umgbhalla/deskhop-type-c/Orignal Files/img/impedance-calculation.png

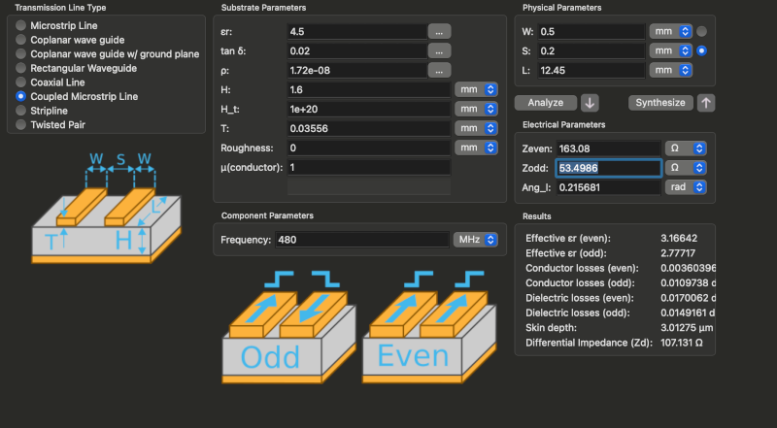
Orignal Files/img/impedance-calculation.png
