umgbhalla/deskhop-type-c/Orignal Files/case/deskhop_case.step

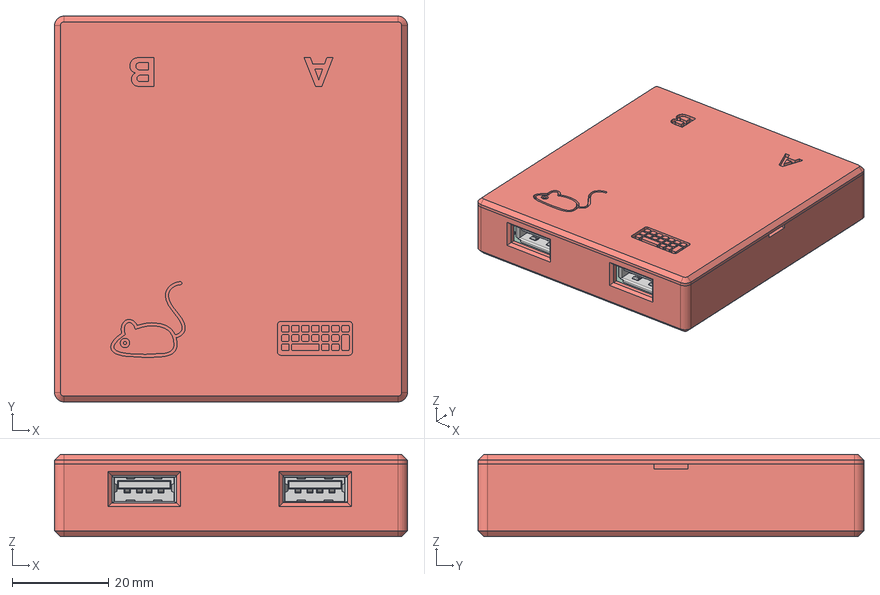
[picture p11: CAD file, 2024-02-20]
Orignal Files/case/deskhop_case.step
73.0 x 79.8 x 17.0 mm
PCB
Box Top
Box Bottom
