umgbhalla/deskhop-type-c/Orignal Files/case/bottom.stl

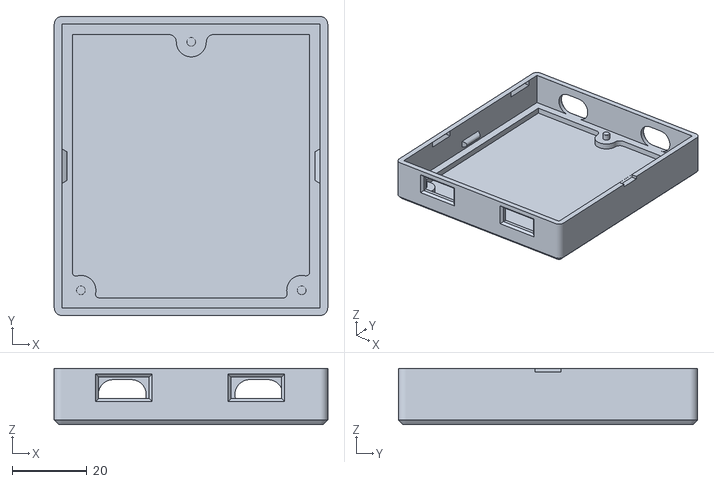
[picture p12: CAD file, 2024-02-20]
Orignal Files/case/bottom.stl
73.0 x 79.8 x 15.0
