umgbhalla/deskhop-type-c/Orignal Files/case/top.stl

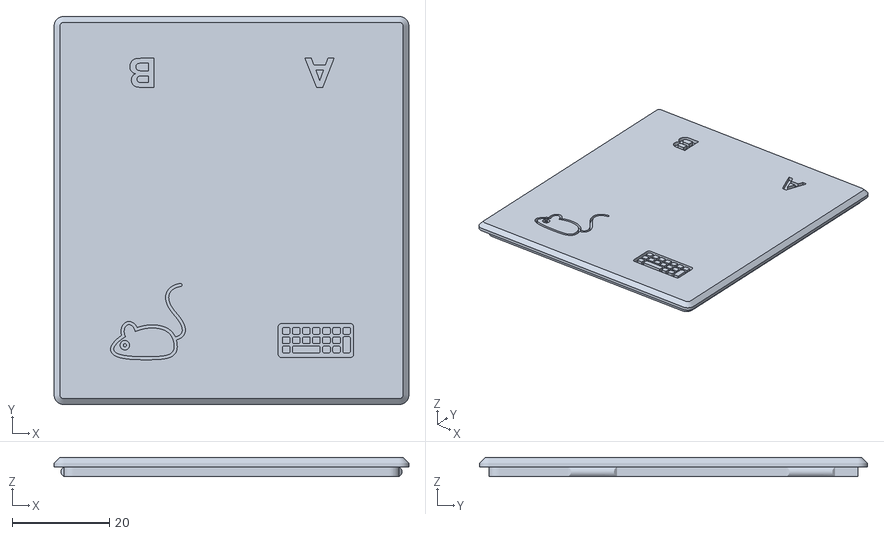
[picture p13: CAD file, 2024-02-20]
Orignal Files/case/top.stl
73.0 x 79.8 x 4.00
