umgbhalla/deskhop-type-c/(list of files, cad)

Other CAD files:
Orignal Files/case/deskhop_case.f3d
