umgbhalla/deskhop-type-c/pcb/DeskHop.kicad_pcb

## KiCad design pcb/DeskHop.kicad_pcb (2024-05-03)

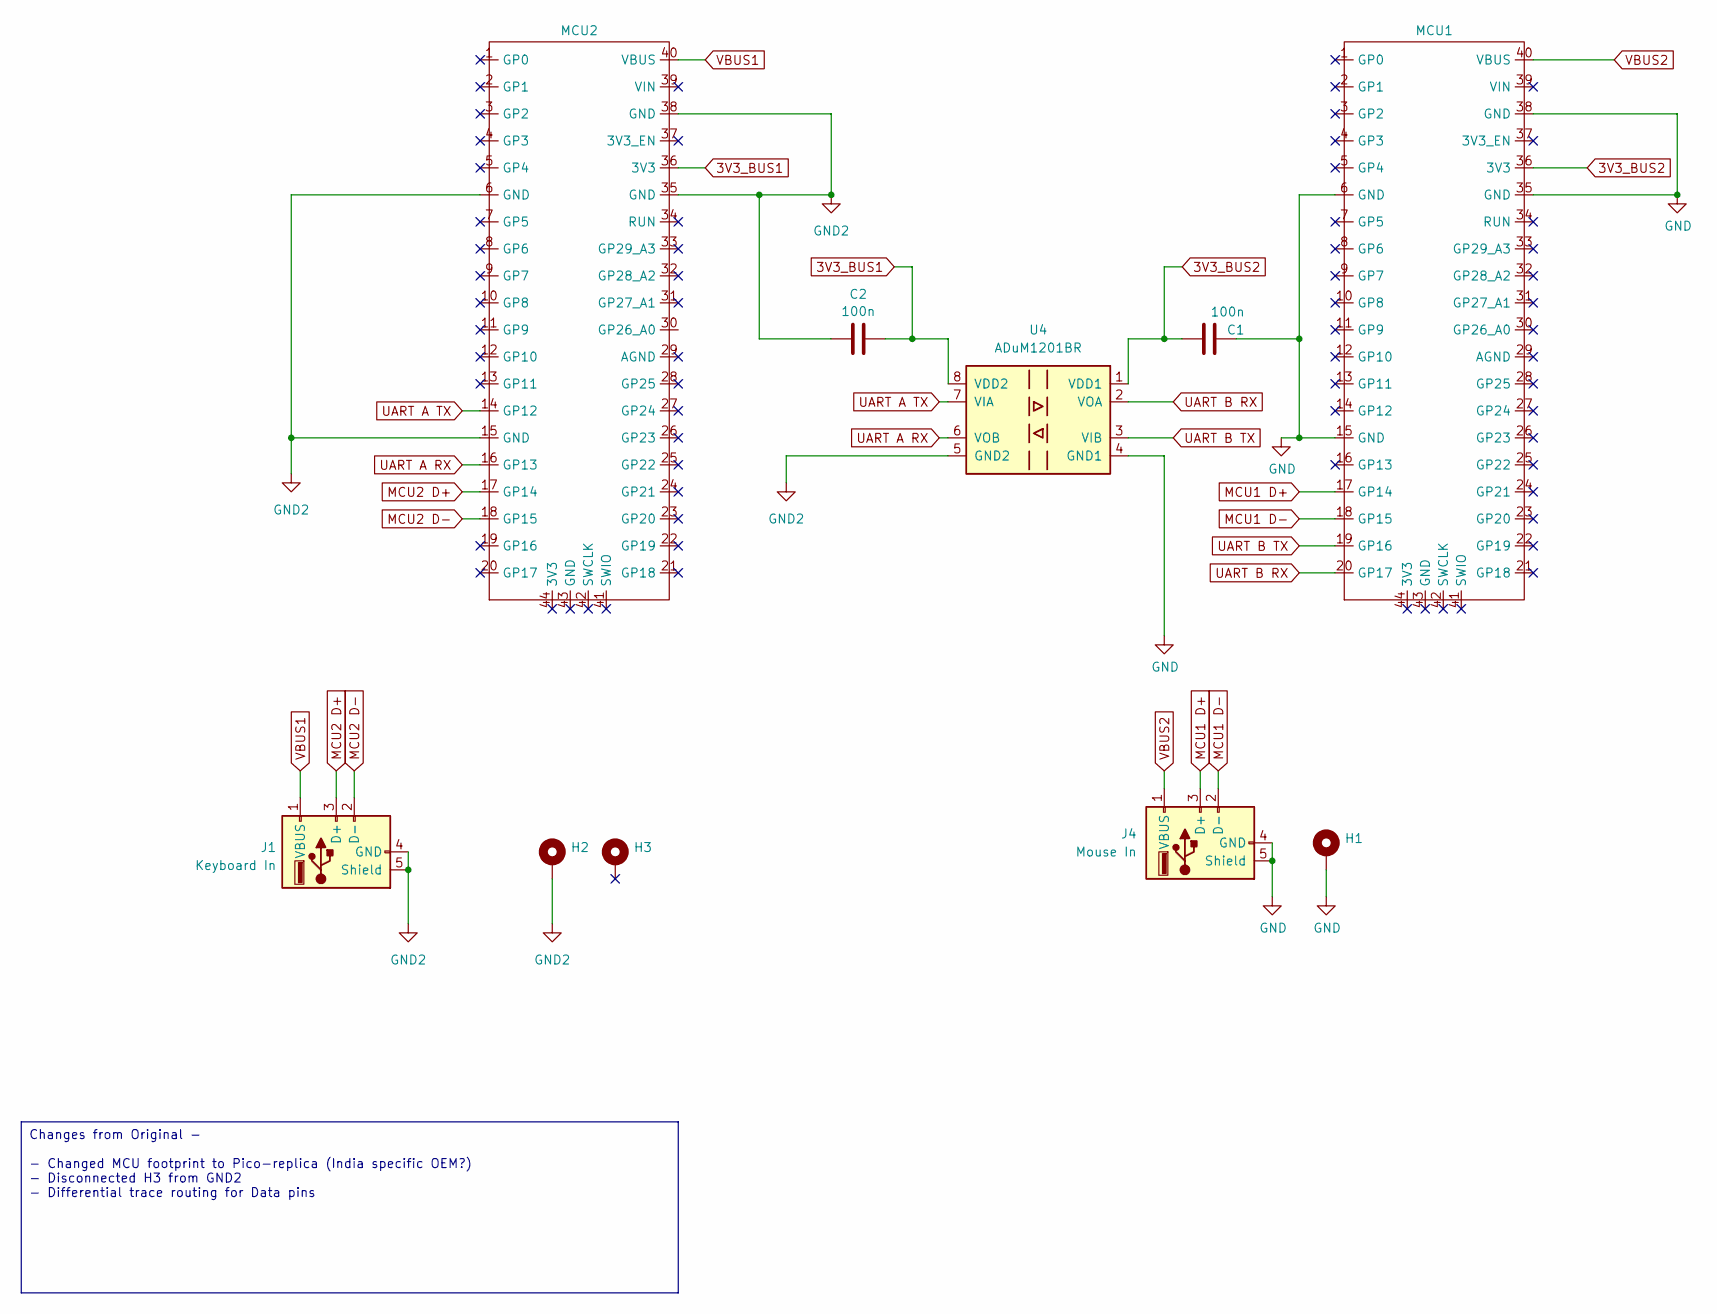
[picture p14: schematic DeskHop.kicad_sch, DeskHop - Fast Keyboard/Mouse Switching Device - Type C]

Parts:
C1, C2: 100n; C_1206_3216Metric_Pad1.33x1.80mm_HandSolder
H1, H2: MountingHole_Pad; MountingHole_2.7mm_M2.5_Pad_TopBottom
H3: MountingHole_Pad; MountingHole_2.7mm_M2.5_Pad_TopOnly
J1: Keyboard In; USB_A_Molex_67643_Horizontal
J4: Mouse In; USB_A_Molex_67643_Horizontal
MCU1, MCU2: Pico_like
U4: ADuM1201BR; SOIC-8_3.9x4.9mm_P1.27mm

Connections:
3V3_BUS1: C2.2, MCU2.36 (3V3), U4.8 (VDD2)
3V3_BUS2: C1.1, MCU1.36 (3V3), U4.1 (VDD1)
GND: C1.2, H1.1, J4.4 (GND), J4.5 (Shield), MCU1.6 (GND), MCU1.15 (GND), MCU1.35 (GND), MCU1.38 (GND), U4.4 (GND1)
GND2: C2.1, H2.1, J1.4 (GND), J1.5 (Shield), MCU2.6 (GND), MCU2.15 (GND), MCU2.35 (GND), MCU2.38 (GND), U4.5 (GND2)
MCU1 D+: J4.3 (D+), MCU1.17 (GP14)
MCU1 D-: J4.2 (D-), MCU1.18 (GP15)
MCU2 D+: J1.3 (D+), MCU2.17 (GP14)
MCU2 D-: J1.2 (D-), MCU2.18 (GP15)
UART A RX: MCU2.16 (GP13), U4.6 (VOB)
UART A TX: MCU2.14 (GP12), U4.7 (VIA)
UART B RX: MCU1.20 (GP17), U4.2 (VOA)
UART B TX: MCU1.19 (GP16), U4.3 (VIB)
VBUS1: J1.1 (VBUS), MCU2.40 (VBUS)
VBUS2: J4.1 (VBUS), MCU1.40 (VBUS)

Notes on the sheet:
Changes from Original - - Changed MCU footprint to Pico-replica (India specific OEM?) - Disconnected H3 from GND2 - Differential trace routing for Data pins

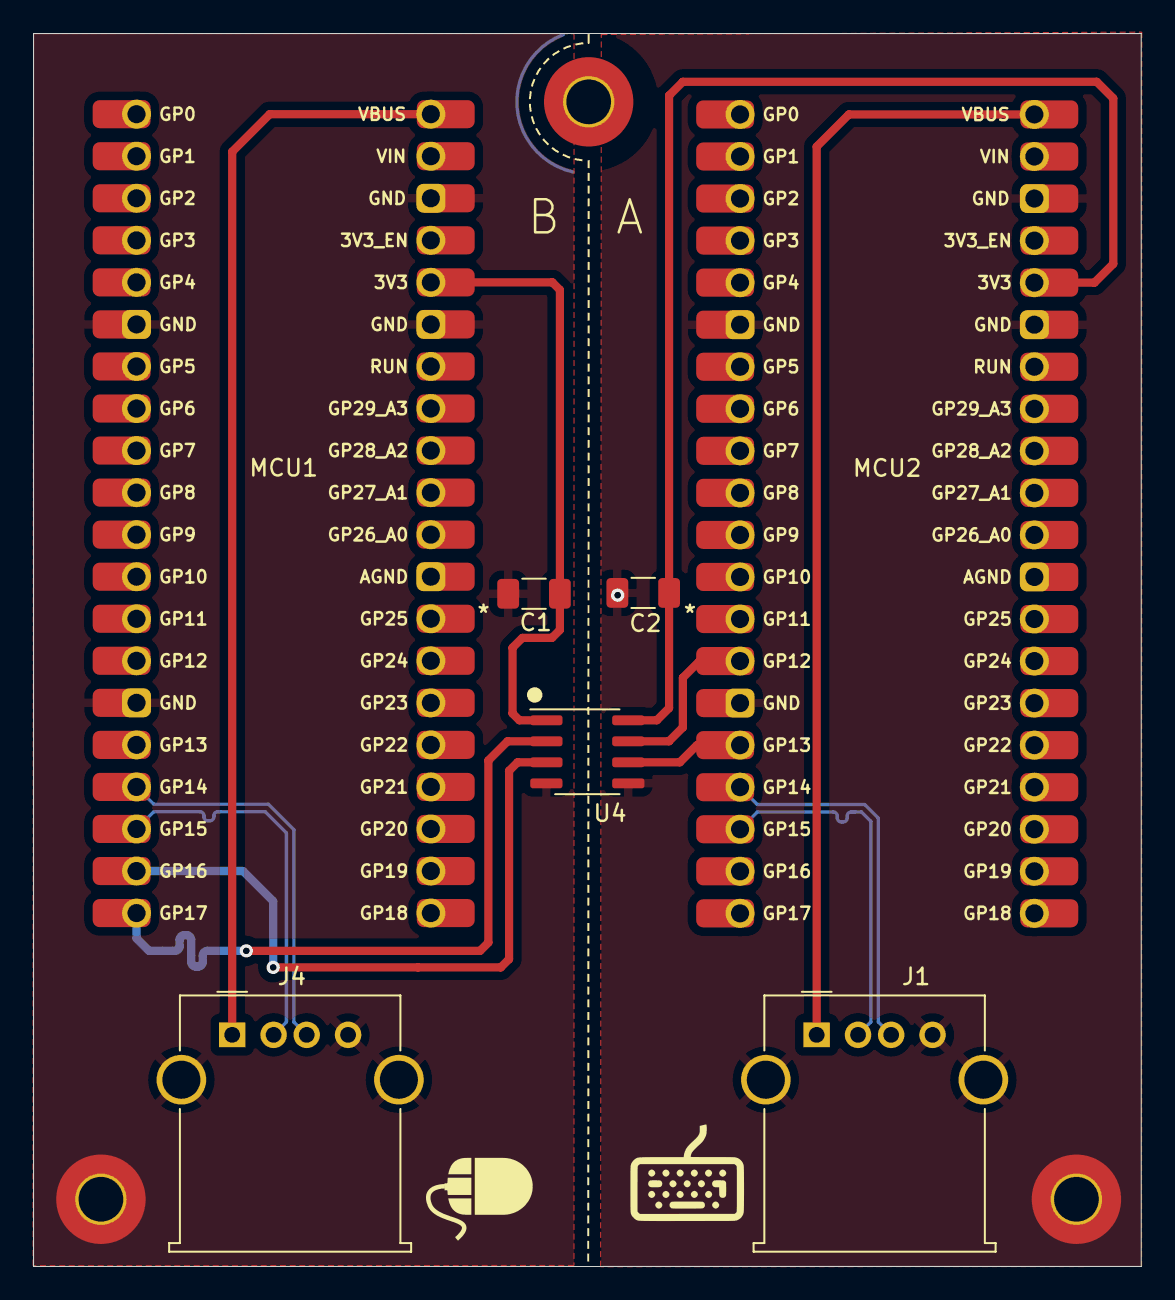
[picture p15: board pcb/DeskHop.kicad_pcb from above]

Board: 2 copper layers, 66.9 x 74.5 mm, 10 parts (0 on the bottom side), 14 nets.
