umgbhalla/deskhop-type-c/Orignal Files/pcb/DeskHop.kicad_pcb

## KiCad design Orignal Files/pcb/DeskHop.kicad_pcb (2024-02-20)

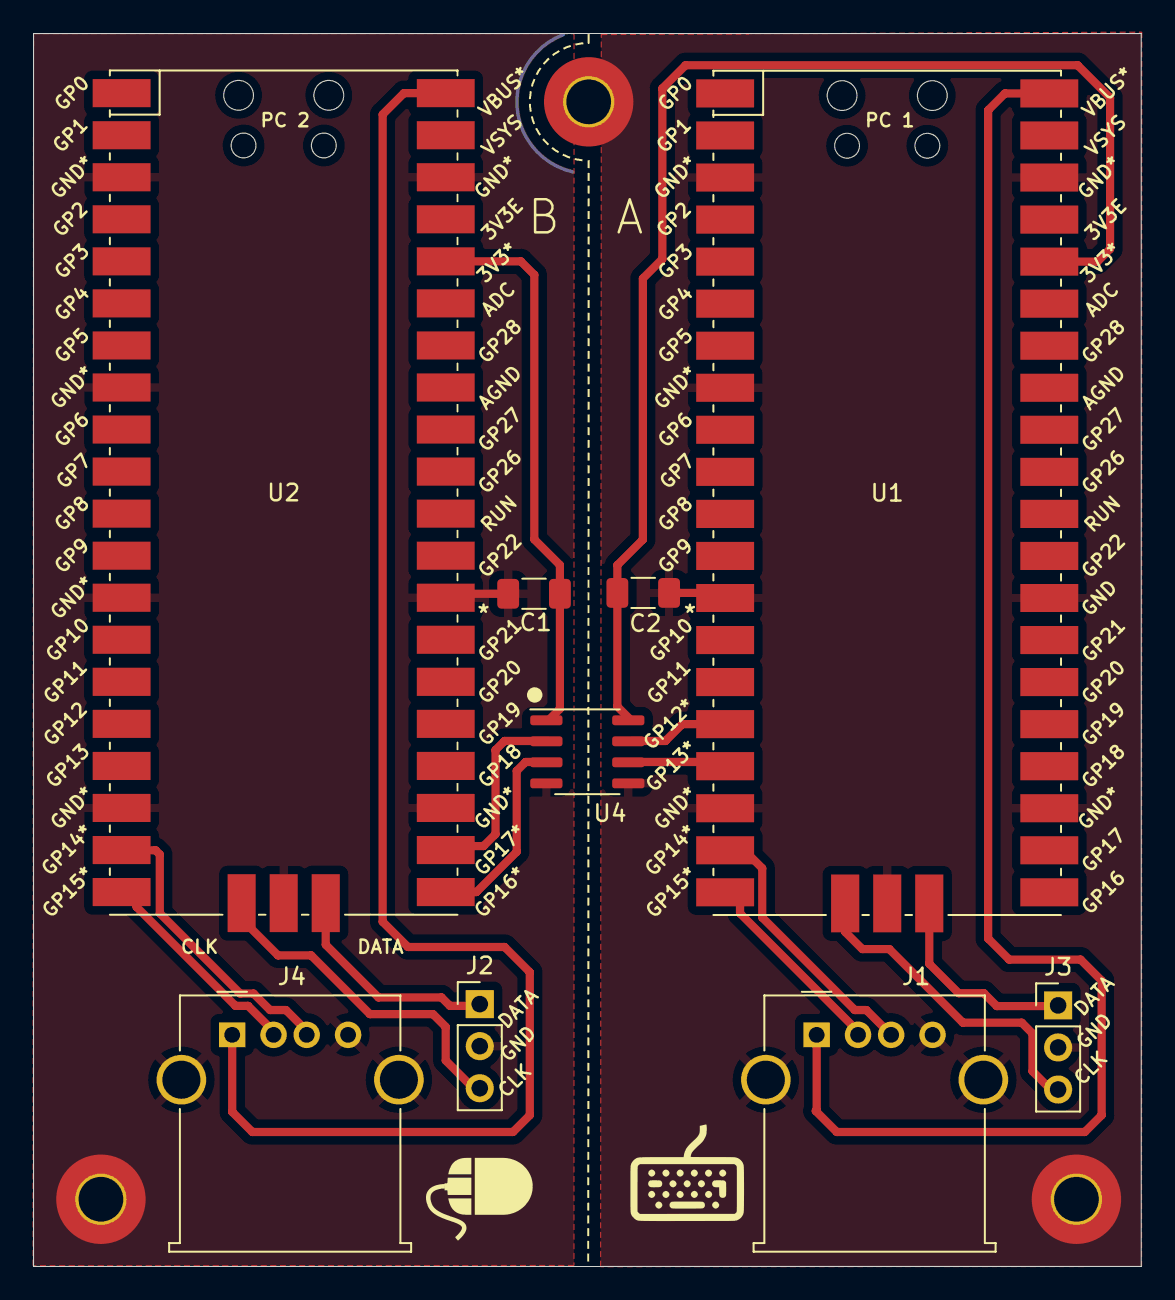
[picture p16: board Orignal Files/pcb/DeskHop.kicad_pcb from above]

Board: 2 copper layers, 66.9 x 74.5 mm, 12 parts (0 on the bottom side), 17 nets.

Parts:
C1, C2: 100n; C_1206_3216Metric_Pad1.33x1.80mm_HandSolder
H1, H2: MountingHole_Pad; MountingHole_2.7mm_M2.5_Pad_TopBottom
H3: MountingHole_Pad; MountingHole_2.7mm_M2.5_Pad_TopOnly
J1: Keyboard In; USB_A_Molex_67643_Horizontal
J2: Debug2; PinHeader_1x03_P2.54mm_Vertical
J3: Debug1; PinHeader_1x03_P2.54mm_Vertical
J4: Mouse In; USB_A_Molex_67643_Horizontal
U1: Pico Primary; RPi_Pico_SMD_Nohole
U2: Pico Secondary; RPi_Pico_SMD_Nohole
U4: ADuM1201BR; SOIC-8_3.9x4.9mm_P1.27mm

Connections:
/UART A TX: U1.16 (GPIO12), U4.7 (VIA)
/UART B RX: U2.22 (GPIO17), U4.2 (VOA)
/UART B TX: U2.21 (GPIO16), U4.3 (VIB)
GND: C1.2, H1.1, J2.2, J4.4 (GND), J4.5 (Shield), U2.3 (GND), U2.8 (GND), U2.13 (GND), U2.18 (GND), U2.23 (GND), U2.28 (GND), U2.38 (GND), U2.42 (GND), U4.4 (GND1)
GND2: C2.2, H2.1, H3.1, J1.4 (GND), J1.5 (Shield), J3.2, U1.3 (GND), U1.8 (GND), U1.13 (GND), U1.18 (GND), U1.23 (GND), U1.28 (GND), U1.38 (GND), U1.42 (GND), U4.5 (GND2)
unnamed: J1.3 (D+), U1.19 (GPIO14)
unnamed: J1.2 (D-), U1.20 (GPIO15)
unnamed: J1.1 (VBUS), U1.40 (VBUS)
unnamed: J2.1, U2.43 (SWDIO)
unnamed: J2.3, U2.41 (SWCLK)
unnamed: J3.1, U1.43 (SWDIO)
unnamed: J3.3, U1.41 (SWCLK)
unnamed: J4.3 (D+), U2.19 (GPIO14)
unnamed: J4.2 (D-), U2.20 (GPIO15)
unnamed: J4.1 (VBUS), U2.40 (VBUS)
unnamed: C2.1, U1.36 (3V3), U4.8 (VDD2)
unnamed: C1.1, U2.36 (3V3), U4.1 (VDD1)
