umgbhalla/deskhop-type-c/Orignal Files/src/handlers.c

/*
 * This file is part of DeskHop (https://github.com/hrvach/deskhop).
 * Copyright (c) 2024 Hrvoje Cavrak
 *
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
 * You should have received a copy of the GNU General Public License
 * along with this program. If not, see <http://www.gnu.org/licenses/>.
 */

#include "main.h"

/**=================================================== *
 * ============  Hotkey Handler Routines  ============ *
 * =================================================== */

/* This is the main hotkey for switching outputs */
void output_toggle_hotkey_handler(device_t *state) {
    /* If switching explicitly disabled, return immediately */
    if (state->switch_lock)
        return;

    state->active_output ^= 1;
    switch_output(state, state->active_output);
};

/* This key combo records switch y top coordinate for different-size monitors  */
void screen_border_hotkey_handler(device_t *state) {
    border_size_t *border = &state->config.output[state->active_output].border;

    /* To avoid having 2 different keys, if we're above half, it's the top coord */
    if (state->mouse_y > (MAX_SCREEN_COORD / 2))
        border->bottom = state->mouse_y;
    else
        border->top = state->mouse_y;

    send_packet((uint8_t *)border, SYNC_BORDERS_MSG, sizeof(border_size_t));
    save_config(state);
};

/* This key combo puts board A in firmware upgrade mode */
void fw_upgrade_hotkey_handler_A(device_t *state) {
    reset_usb_boot(1 << PICO_DEFAULT_LED_PIN, 0);
};

/* This key combo puts board B in firmware upgrade mode */
void fw_upgrade_hotkey_handler_B(device_t *state) {
    send_value(ENABLE, FIRMWARE_UPGRADE_MSG);
};

/* This key combo prevents mouse from switching outputs */
void switchlock_hotkey_handler(device_t *state) {
    state->switch_lock ^= 1;
    send_value(state->switch_lock, SWITCH_LOCK_MSG);
}

/* When pressed, erases stored config in flash and loads defaults on both boards */
void wipe_config_hotkey_handler(device_t *state) {
    wipe_config();
    load_config(state);
    send_value(ENABLE, WIPE_CONFIG_MSG);
}

void screensaver_hotkey_handler(device_t *state) {
    state->config.screensaver_enabled ^= 1;
    send_value(state->config.screensaver_enabled, SCREENSAVER_MSG);
}

/* When pressed, toggles the current mouse zoom mode state */
void mouse_zoom_hotkey_handler(device_t *state) {
    state->mouse_zoom ^= 1;
    send_value(state->mouse_zoom, MOUSE_ZOOM_MSG);
};

/**==================================================== *
 * ==========  UART Message Handling Routines  ======== *
 * ==================================================== */

/* Function handles received keypresses from the other board */
void handle_keyboard_uart_msg(uart_packet_t *packet, device_t *state) {
    queue_kbd_report((hid_keyboard_report_t *)packet->data, state);
    state->last_activity[BOARD_ROLE] = time_us_64();
}

/* Function handles received mouse moves from the other board */
void handle_mouse_abs_uart_msg(uart_packet_t *packet, device_t *state) {
    mouse_abs_report_t *mouse_report = (mouse_abs_report_t *)packet->data;
    queue_mouse_report(mouse_report, state);

    state->mouse_x = mouse_report->x;
    state->mouse_y = mouse_report->y;

    state->last_activity[BOARD_ROLE] = time_us_64();
}

/* Function handles request to switch output  */
void handle_output_select_msg(uart_packet_t *packet, device_t *state) {
    state->active_output = packet->data[0];
    if (state->tud_connected)
        release_all_keys(state);

    restore_leds(state);
}

/* On firmware upgrade message, reboot into the BOOTSEL fw upgrade mode */
void handle_fw_upgrade_msg(uart_packet_t *packet, device_t *state) {
    reset_usb_boot(1 << PICO_DEFAULT_LED_PIN, 0);
}

/* Comply with request to turn mouse zoom mode on/off  */
void handle_mouse_zoom_msg(uart_packet_t *packet, device_t *state) {
    state->mouse_zoom = packet->data[0];
}

/* Process request to update keyboard LEDs */
void handle_set_report_msg(uart_packet_t *packet, device_t *state) {
    state->keyboard_leds[BOARD_ROLE] = packet->data[0];
    restore_leds(state);
}

/* Process request to block mouse from switching, update internal state */
void handle_switch_lock_msg(uart_packet_t *packet, device_t *state) {
    state->switch_lock = packet->data[0];
}

/* Handle border syncing message that lets the other device know about monitor height offset */
void handle_sync_borders_msg(uart_packet_t *packet, device_t *state) {
    border_size_t *border = &state->config.output[state->active_output].border;
    memcpy(border, packet->data, sizeof(border_size_t));
    save_config(state);
}

/* When this message is received, flash the locally attached LED to verify serial comms */
void handle_flash_led_msg(uart_packet_t *packet, device_t *state) {
    blink_led(state);
}

/* When this message is received, wipe the local flash config */
void handle_wipe_config_msg(uart_packet_t *packet, device_t *state) {
    wipe_config();
    load_config(state);
}

void handle_screensaver_msg(uart_packet_t *packet, device_t *state) {
    state->config.screensaver_enabled = packet->data[0];
}

/**==================================================== *
 * ==============  Output Switch Routines  ============ *
 * ==================================================== */

/* Update output variable, set LED on/off and notify the other board so they are in sync. */
void switch_output(device_t *state, uint8_t new_output) {
    state->active_output = new_output;
    restore_leds(state);
    send_value(new_output, OUTPUT_SELECT_MSG);

    /* If we were holding a key down and drag the mouse to another screen, the key gets stuck.
       Changing outputs = no more keypresses on the previous system. */
    release_all_keys(state);
}
