umgbhalla/deskhop-type-c/Orignal Files/src/defaults.c

#include "main.h"

/* Default configuration */
const config_t default_config = {
    .magic_header = 0xB00B1E5,
    .version = CURRENT_CONFIG_VERSION,
    .output[OUTPUT_A] =
        {
            .number = OUTPUT_A,
            .speed_x = MOUSE_SPEED_A_FACTOR_X,
            .speed_y = MOUSE_SPEED_A_FACTOR_Y,
            .border = {
                .top = 0,
                .bottom = MAX_SCREEN_COORD,
            },
            .screen_count = 1,
            .screen_index = 0,
        },        
    .output[OUTPUT_B] =
        {
            .number = OUTPUT_B,
            .speed_x = MOUSE_SPEED_B_FACTOR_X,
            .speed_y = MOUSE_SPEED_B_FACTOR_Y,
            .border = {
                .top = 0,
                .bottom = MAX_SCREEN_COORD,
            },
            .screen_count = 1,
            .screen_index = 0,
        },
    .screensaver_enabled = SCREENSAVER_ENABLED,
};
