umgbhalla/deskhop-type-c/(commit log)

2024-02-20 Changed design to Type C pico copy
    Modifications done to adapt design to Type C version of Pico-copy available in India. Detail changes in PCB Schematics.
    [DeskHop-B_Cu.gbr, DeskHop-B_Mask.gbr, DeskHop-B_Paste.gbr, DeskHop-B_Silkscreen.gbr, DeskHop-Edge_Cuts.gbr, DeskHop-F_Cu.gbr, DeskHop-F_Mask.gbr, DeskHop-F_Paste.gbr]
2024-05-03 reverted back to orignal GPIO for MCU 1
    [DeskHop.kicad_pcb, DeskHop.kicad_sch]
2024-05-03 GND fill error sorted
    [DeskHop.kicad_pcb]
